OJinJin-Milktea/smart-car/picture/motorlogic.jpg

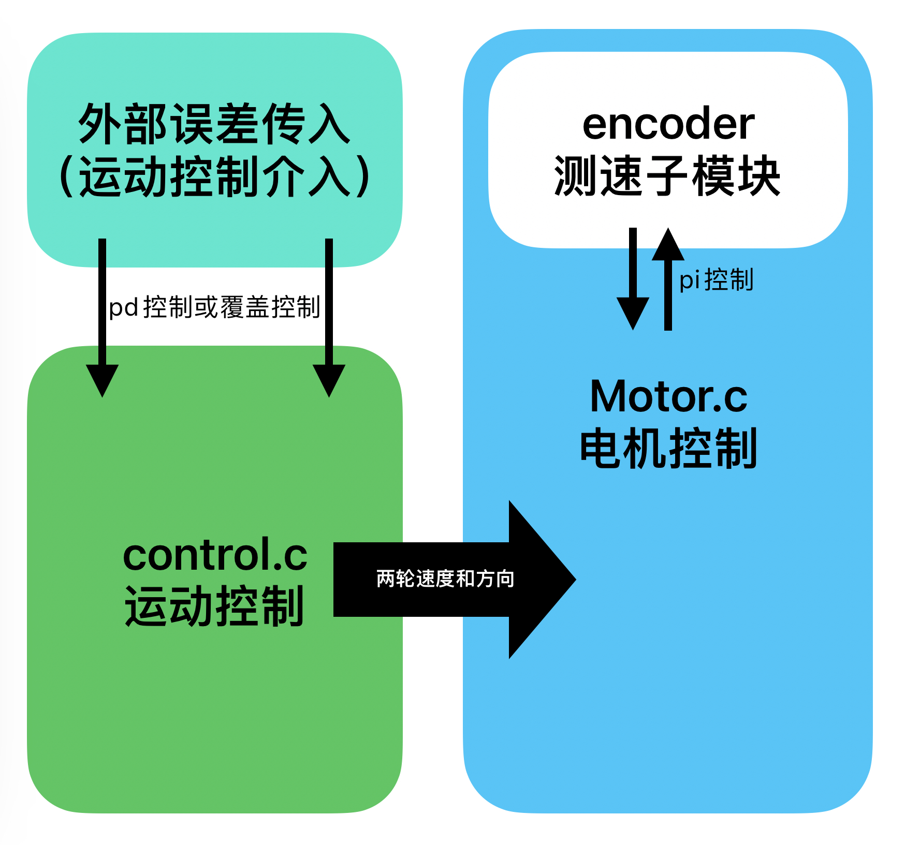
picture/motorlogic.jpg
