OJinJin-Milktea/smart-car/board/CubeMX_Config/CubeMX_Config.ioc

Mcu.UserName=STM32F407ZGTx
PA1.Signal=ADCx_IN1
PA10.Signal=USART1_RX
PA11.Signal=USB_OTG_FS_DM
PA12.Signal=USB_OTG_FS_DP
PA13.Signal=SYS_JTMS-SWDIO
PA14.Signal=SYS_JTCK-SWCLK
PA2.Signal=USART2_TX
PA3.Signal=USART2_RX
PA4.Signal=COMP_DAC1_group
PA5.Signal=GPIO_Output
PA6.Signal=GPIO_Output
PA7.Signal=S_TIM3_CH2
PA9.Signal=USART1_TX
PB1.Signal=S_TIM3_CH4
PB10.Signal=S_TIM2_CH3
PB11.Signal=S_TIM2_CH4
PB13.Signal=SPI2_SCK
PC10.Signal=SDIO_D2
PC11.Signal=SDIO_D3
PC12.Signal=SDIO_CK
PC14-OSC32_IN.Signal=RCC_OSC32_IN
PC15-OSC32_OUT.Signal=RCC_OSC32_OUT
PC2.Signal=SPI2_MISO
PC3.Signal=SPI2_MOSI
PC8.Signal=SDIO_D0
PC9.Signal=SDIO_D1
PD0.Signal=FSMC_D2_DA2
PD1.Signal=FSMC_D3_DA3
PD12.Signal=S_TIM4_CH1
PD13.Signal=FSMC_A18
PD14.Signal=FSMC_D0_DA0
PD15.Signal=FSMC_D1_DA1
PD2.Signal=SDIO_CMD
PD4.Signal=FSMC_NOE
PD5.Signal=FSMC_NWE
PE10.Signal=FSMC_D7_DA7
PE11.Signal=S_TIM1_CH2
PE13.Signal=S_TIM1_CH3
PE2.Signal=GPIO_Output
PE3.Signal=GPIO_Output
PE4.Signal=GPIO_Output
PE5.Signal=GPIO_Output
PE7.Signal=FSMC_D4_DA4
PE8.Signal=FSMC_D5_DA5
PE9.Signal=FSMC_D6_DA6
PF4.Signal=ADC3_IN14
PF5.Signal=ADC3_IN15
PF6.Signal=ADC3_IN4
PF7.Signal=ADC3_IN5
PF9.Signal=S_TIM14_CH1
PG10.Signal=FSMC_NE3
PG11.Signal=ETH_TX_EN
PG13.Signal=ETH_TXD0
PG14.Signal=ETH_TXD1
PH0-OSC_IN.Signal=RCC_OSC_IN
PH1-OSC_OUT.Signal=RCC_OSC_OUT
